nincsmega71/CL-415/README.md

# CL-415 RC vízibombázó

Kétmotoros, kefe nélküli hajtású Canadair CL-415 RC modell XPS habból, behúzható futóművel és az igazi géphez hasonló jelzőfényekkel.

Jelzőfények felülnézetben

## Főbb adatok

| | |
|---|---|
| Fesztáv | 1800 mm |
| Szárnyfelület | kb. 40 dm² |
| Súlycél | víz nélkül kb. 2,2–2,4 kg; 500 ml vízzel kb. 2,9 kg |
| Anyag | 5 mm XPS padlóalátét, 3 mm rétegelt lemez, coroplast / üvegszövet a hajótest alján |
| Hajtás | 2× 2830 1000–1100 kV, 2× 40 A ESC, 2× 8×6 négytollú (CW + CCW), 3S LiPo |
| Rádió | Turnigy TGY-i10 adó, FlySky FS-iA10B vevő (10 csatorna), i-BUS telemetria (feszültség, hőmérséklet, fordulatszám) |
| Futómű | behúzható: a Dumas-féle CL-215 futómű átméretezve (lengőkar + reteszelő merevítő, nyomtáv 328 mm), hátra behúzható ikerkerekes orrfutó; 5 szervó, saját XIAO vezérlővel |
| Fények és víz | helyzetfények, piros villogó, strobe, leszállófény; 500 ml-es kétrekeszes víztartály merítőlapokkal és két ürítőajtóval; Seeed XIAO RP2040 vezérlő i-BUS-on |

## Dokumentáció

| Fájl | Tartalom |
|---|---|
| [docs/SZERELESI_UTMUTATO.md](docs/SZERELESI_UTMUTATO.md) | Szerelési útmutató: fénypanel, firmware, fények, futómű, hajtás, RC bekötés, vízzárás, festés, végellenőrzés |
| [docs/FEDELZETI_VEZERLO.md](docs/FEDELZETI_VEZERLO.md) | Fedélzeti vezérlő v2 (XIAO, i-BUS): működés, kapcsolási rajz, lábkiosztás, teszt, beállítás |
| [docs/ADO_TURNIGY_I10.md](docs/ADO_TURNIGY_I10.md) | Turnigy i10 adó és FS-iA10B vevő: kezelőszervek, funkciókiosztás, failsafe, telemetria |
| [docs/I10_FIRMWARE_ELEMZES.md](docs/I10_FIRMWARE_ELEMZES.md) | Az i10 gyári firmware-ének vizsgálata: mi módosítható, kockázatok, következő lépés |
| [docs/FUTOMU_ES_TARTALY.md](docs/FUTOMU_ES_TARTALY.md) | Futómű és víztartály méretezett terve, SolidWorks-hez |
| [cad/](cad/) | DXF és STEP alkatrészek, összeállítások, SolidWorks paraméterlista, generálóprogramok |
| [docs/VIZTARTALY.md](docs/VIZTARTALY.md) | Víztartály: mennyi vizet bír a gép, tartály, ürítés, merítés |
| [docs/BOM.md](docs/BOM.md) | Alkatrészlista: fényvezérlő és teljes gép |
| [docs/TERVEK_ES_FORRASOK.md](docs/TERVEK_ES_FORRASOK.md) | A Paper-Replika terv letöltései és további források |
| [docs/elektronika.html](docs/elektronika.html) | Kapcsolási rajz és BOM egy oldalon (böngészőben megnyitható) |
| [docs/CL-415_Canadair_festes_matrica.pdf](docs/CL-415_Canadair_festes_matrica.pdf) | Canadair-stílusú festési séma és matricaív (A3) |
| [docs/img/](docs/img/) | Ábrák SVG-ben |
| [firmware/cl415_vezerlo/](firmware/cl415_vezerlo/cl415_vezerlo.ino) | Fedélzeti vezérlő firmware v2 (FS-iA10B, i-BUS) |
| [firmware/cl415_futomu/](firmware/cl415_futomu/cl415_futomu.ino) | Futómű-vezérlő (második XIAO): a főfutó szervóinak összehangolt mozgatása |
| [firmware/cl415_lights/](firmware/cl415_lights/cl415_lights.ino) | Régi fényvezérlő (v1, TGY-iA6B vevőhöz, CH5 PWM) |

## Ábrák

| | |
|---|---|
| Kapcsolási rajz v2 | Szárnykábelezés |
| Csatornakiosztás | Főfutó elölnézet |
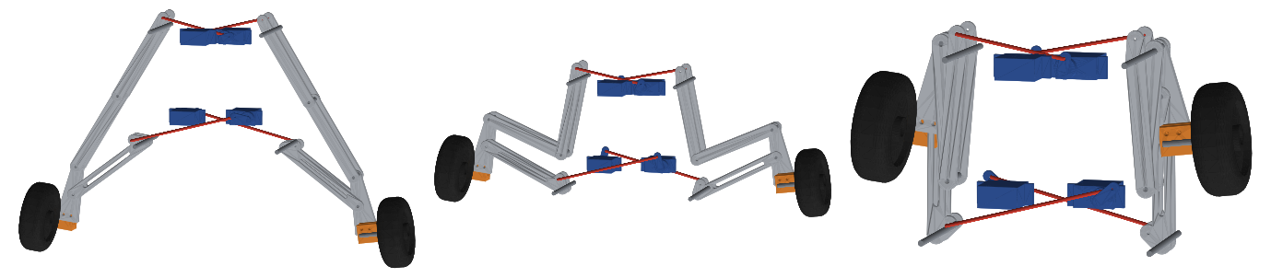
[picture p1: docs/img/step_elonezet.png]
3D modell
| A futómű mozgása |  |

## A sárkányszerkezet terve

A modell a [Paper-Replika CL-415](https://paper-replika.com/index.php/rc-foam-project/bombardier-cl-415-rc-plane-part-1?showall=1) ingyenes terve alapján épül (Julius Perdana). A tervek a szerző oldaláról tölthetők le; ebben a repóban csak a hivatkozások szerepelnek.
