nincsmega71/CL-415/docs/TERVEK_ES_FORRASOK.md

# Tervek és források

## A választott terv: Paper-Replika CL-415 (180 cm)

Julius Perdana ingyenes, habból épülő terve. Vízről és földről is üzemeltethető, a szárny három részre szedhető, és levehető a törzsről.

Eredeti adatok: 1800 mm fesztáv, 22 cm húr, 40 dm² szárnyfelület, kb. 2200 g repülősúly, 5 mm Depron/polifoam + 3 mm rétegelt lemez, 2× 2830 1000 kV motor, 2× 40 A ESC, 3S LiPo, 7 db 9 g-os szervó, 2× 8×6 négytollú légcsavar.

Ebben a projektben 5 mm-es XPS padlóalátéttel épül, 100%-os méretben, így a terv hornyai változtatás nélkül passzolnak.

| Rész | Tartalom | Link |
|---|---|---|
| 1. rész | törzs, függőleges vezérsík, futók | [cikk](https://paper-replika.com/index.php/rc-foam-project/bombardier-cl-415-rc-plane-part-1?showall=1) |
| 2. rész | vízszintes vezérsík, szervók, tolórudak | [cikk](https://paper-replika.com/index.php/rc-foam-project/bombardier-cl-415-rc-plane-part-2) |
| 3. rész | szárny | [PDF](https://paper-replika.com/dfiles/rcplans/PR_CL415_Part3.pdf) · [cikk](https://paper-replika.com/index.php/rc-foam-project/bombardier-cl-415-rc-plane-part-3) |
| 4. rész | úszók, befejezés | [PDF](https://paper-replika.com/dfiles/rcplans/PR_CL415_Part4.pdf) · [cikk](https://paper-replika.com/index.php/rc-foam-project/bombardier-cl-415-rc-plane-part-4) |

Nyomtatáskor „Tényleges méret” (100%) legyen beállítva, és az első lapon vonalzóval ellenőrizd a méretet.

A szerző tapasztalatai: az orrfutó kiugrott a helyéből (ezért itt csavarozott rétegelt lemez talpat kap), a csűrőfelületet meg kellett növelni, fordulóban sok oldalkormány kell.

## További tervek és modellek (referenciának)

| Forrás | Leírás |
|---|---|
| [Outerzone oz9788 – Mike Roach](https://outerzone.co.uk/plan_details.asp?ID=9788) | Bombardier CL-415, 1/24, 52" (≈1320 mm), Depron, ingyenes |
| [Outerzone oz16517 – Bernard Dumas](https://outerzone.co.uk/plan_details.asp?ID=16517) | Canadair CL-215, 2220 mm, vektoros PDF |
| [Outerzone oz6182 – Steve Gray](https://outerzone.co.uk/plan_details.asp?ID=6182) | Canadair CL-215, 76", sport-scale |
| [Aeronaut CL-415 építési útmutató](https://aero-naut.de/downloads/en/anleitungen/1343-00-Canadair_instructions_en.pdf) | 1505 mm-es fa készlet útmutatója, hajótest- és gondola-referencia |
| [Cults3D – Katraska CL-415](https://cults3d.com/en/3d-model/game/canadair-cl-415-katraska) | 1562 mm, LW-PLA, fizetős |
| [DARcorporation CL-415 CAD](https://shop.darcorp.com/index.php?route=product%2Fproduct&product_id=281) | külső forma, STEP / Parasolid, fizetős |
