nincsmega71/CL-415/docs/CL-415_Canadair_festes_matrica.pdf

# CL-415 – Canadair-stílusú festési séma

A klasszikus sárga–piros Canadair tűzoltógépek ihlette színezés a 180 cm-es Paper-Replika modellhez. Az ábrák nem méretarányosak.

## Oldalnézet (bal oldal)

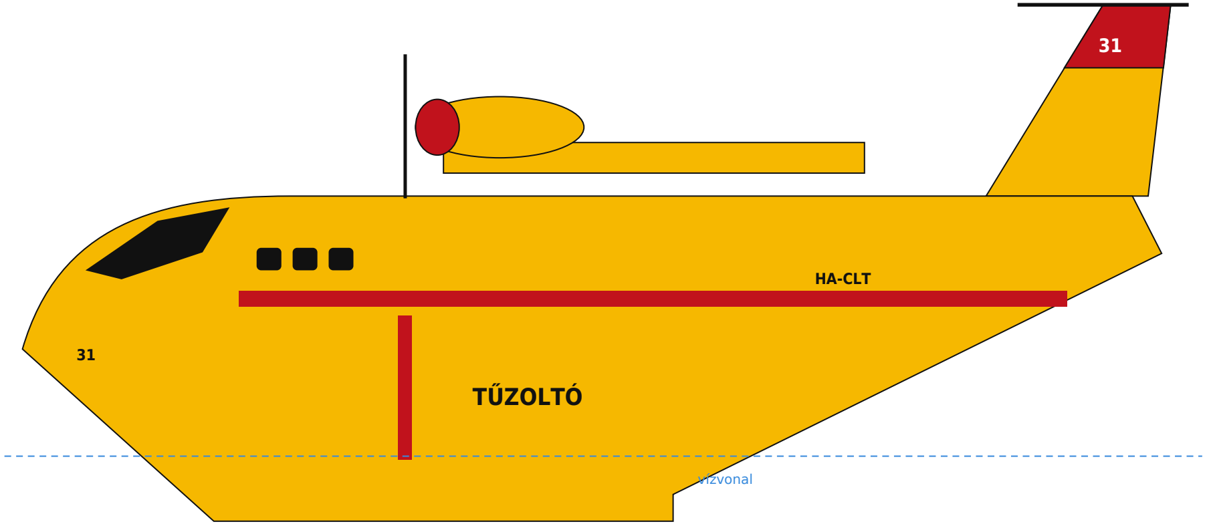
[picture p2: figure]
TŰZOLTÓ; HA-CLT; vízvonal

## Felülnézet

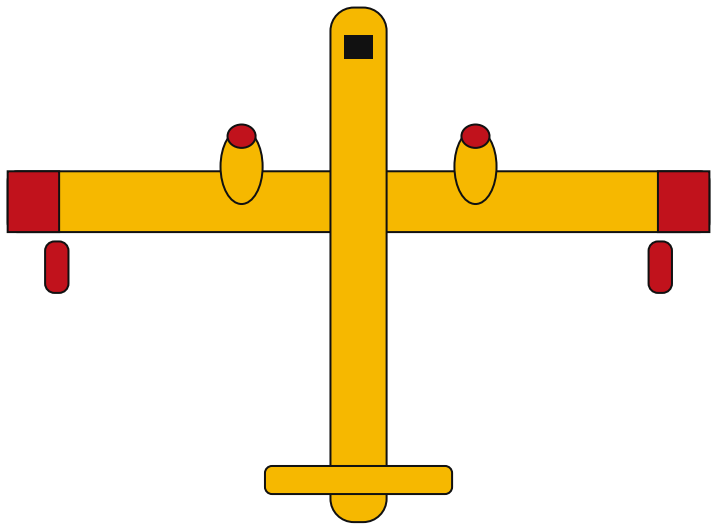
[picture p3: figure]

Alul: „HA-CLT” a bal szárny alsó felén, a szárnyvégtől befelé.

## Színek (vízbázisú akril; a RAL csak tájékoztató)

Sárga | RAL 1021 körül | törzs, szárny, vezérsíkok, gondolák – alapszín
Piros | RAL 3020 körül | függőleges vezérsík felső harmada, szárnyvégek (kb. 10 cm), úszók, gondolaorr, díszcsík, légcsavar-veszély csík
Fekete | RAL 9005 | tükröződésgátló mező a szélvédő előtt, ablakok (matrica), feliratok (matrica)
Fehér | – | számok a piros vezérsíkon (matrica)

## Festési sorrend

1. Vízzárás (coroplast / üvegszövet + epoxi) és csiszolás után vékony vízbázisú alapozó.
2. Sárga alapszín az egész gépre, 2–3 vékony rétegben ecsettel vagy hengerrel. Spray és oldószeres festék tilos (oldja az XPS-t).
3. Maszkolás papírszalaggal, majd a piros felületek. Utána a fekete tükröződésgátló mező.
4. Matricák felrakása (2. oldal), majd vízbázisú matt vagy selyemfényű lakk az egészre – ez védi a matricákat a víztől is.

Fiktív lajstrom és szám (HA-CLT, 31). Saját ötlet alapján, a valódi Canadair tűzoltógépek jellegzetes színezésére emlékeztetve.

## CL-415 – Canadair-stílusú matricák · fehér öntapadós vinyl · A3, 100%-os nyomtatás

Tintasugaras nyomtatóhoz való fehér vinyl matricapapírra nyomtasd, majd fújás helyett vízbázisú lakkal vagy átlátszó laminálófóliával védd. A szürke feliratokat ne vágd ki.

vezérsík-szám ×2 (piros alap)

31

vezérsík-szám ×2 (piros alap)

# 31 HA-CLT

lajstrom, bal szárny alul

# HA-CLT

lajstrom, törzs hátul ×2

# HA-CLT

lajstrom, törzs hátul ×2 | TŰZOLTÓ

törzs oldala ×2

# TŰZOLTÓ

törzs oldala ×2

31

orrszám ×2

31

orrszám ×2

CL-415

típusjel ×2

CL-415

típusjel ×2

# LÉGCSAVAR – VESZÉLY

légcsavar-veszély csík ×2

# LÉGCSAVAR – VESZÉLY

légcsavar-veszély csík ×2

# NE LÉPJ

szárnytő, vezérsík ×6

# NE LÉPJ

szárnytő, vezérsík ×6

# NE LÉPJ

szárnytő, vezérsík ×6

# NE LÉPJ

szárnytő, vezérsík ×6

# NE LÉPJ

szárnytő, vezérsík ×6

# NE LÉPJ

szárnytő, vezérsík ×6

piros díszcsík ×4 (törzs oldala, kettő oldalanként, toldva)

Méretellenőrzés: ennek a vonalnak pontosan 100 mm-nek kell lennie.
