nincsmega71/CL-415/cad/dxf/fo2_lengokar.dxf

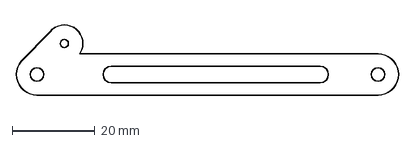
[picture p4: CAD file, 2026-11-07]
cad/dxf/fo2_lengokar.dxf
92.6 x 17.0 mm
