nincsmega71/CL-415/cad/step/alkatreszek/tartaly_test.step

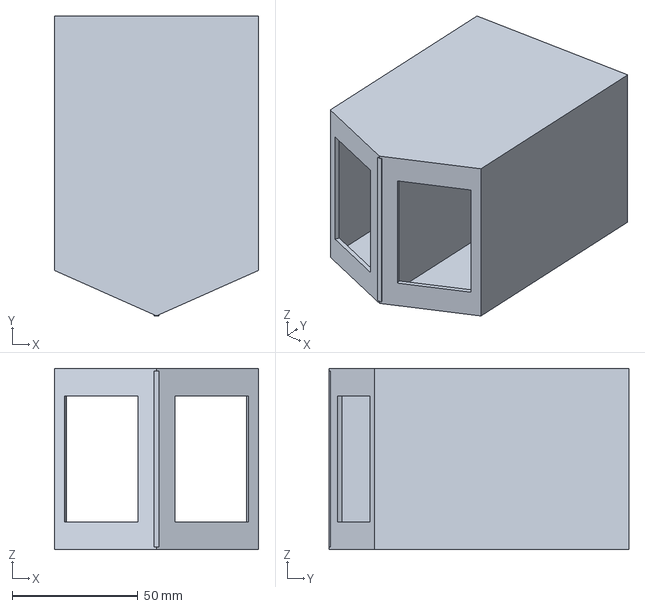
[picture p5: CAD file, 2026-11-07]
cad/step/alkatreszek/tartaly_test.step
81.0 x 119.0 x 72.0 mm
