nincsmega71/CL-415/cad/dxf/fo2_akna_belso_fal.dxf

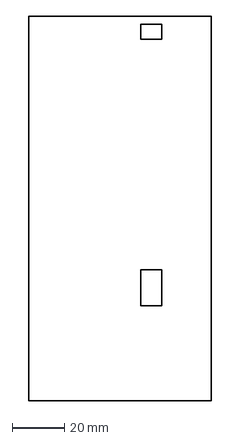
[picture p7: CAD file, 2026-11-07]
cad/dxf/fo2_akna_belso_fal.dxf
70.0 x 147.7 mm
