nincsmega71/CL-415/cad/step/alkatreszek/fo2_merevito_felso.step

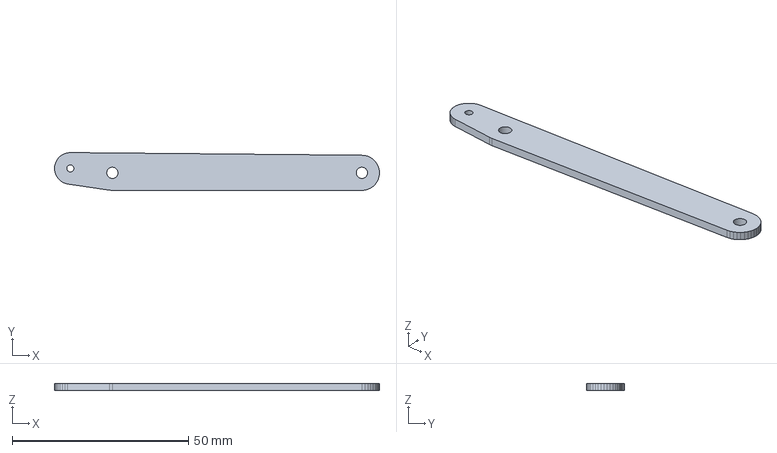
[picture p8: CAD file, 2026-11-07]
cad/step/alkatreszek/fo2_merevito_felso.step
92.3 x 10.8 x 2.00 mm
