nincsmega71/CL-415/cad/dxf/orrfuto_lab.dxf

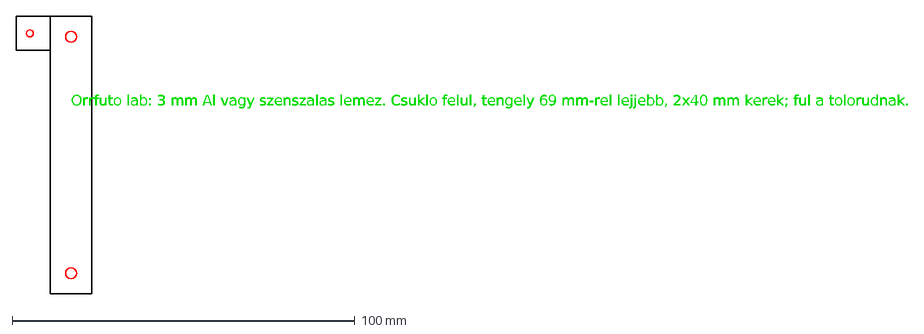
[picture p10: CAD file, 2026-11-07]
cad/dxf/orrfuto_lab.dxf
Orrfuto lab: 3 mm Al vagy szenszalas lemez. Csuklo felul, tengely 69 mm-rel lejjebb, 2x40 mm kerek; ful a tolorudnak.
