nincsmega71/CL-415/cad/step/alkatreszek/csapagy_MR63_3x6x2_5.step

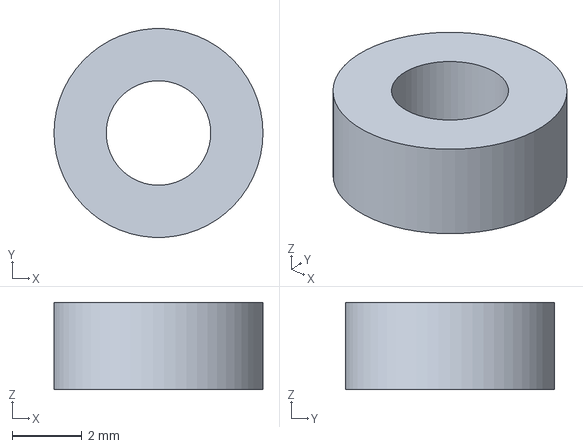
[picture p11: CAD file, 2026-11-07]
cad/step/alkatreszek/csapagy_MR63_3x6x2_5.step
6.00 x 5.99 x 2.50 mm
