nincsmega71/CL-415/cad/step/fofuto_felut.step

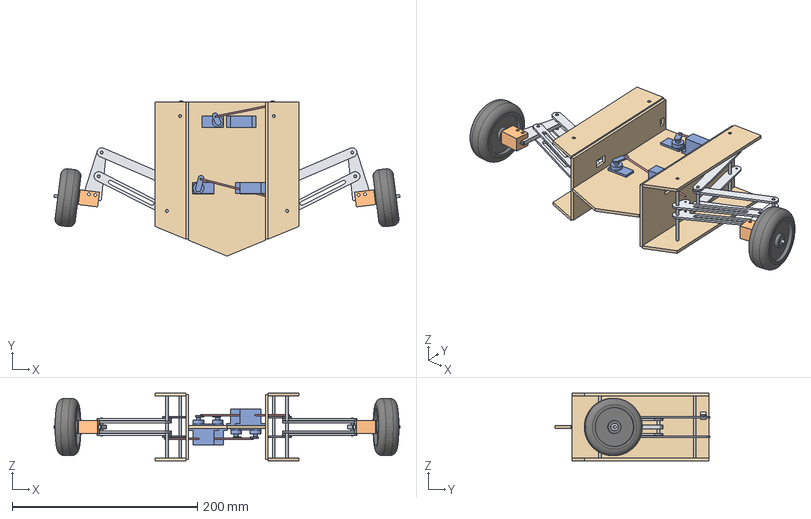
[picture p12: CAD file, 2026-11-07]
cad/step/fofuto_felut.step
373.3 x 167.4 x 73.0 mm
kozepso_former
belso_fal_J
akna_fal_Je
akna_fal_Jh
lengokar_Je
lengokar_Jh
merev_also_Je
merev_also_Jh
merev_felso_Je
merev_felso_Jh
lab_J
kerekbak_J
fokerek_J
csapagy_J1
csapagy_J2
tengely_J
csap_OT_J
csap_OB_J
csap_P1_J
csap_P2_J
csap_K_J
szervo_also_J
szervokar_also_J
szervo_felso_J
szervokar_felso_J
rud_also_J
rud_felso_J
belso_fal_B
akna_fal_Be
akna_fal_Bh
lengokar_Be
lengokar_Bh
merev_also_Be
merev_also_Bh
merev_felso_Be
merev_felso_Bh
lab_B
kerekbak_B
fokerek_B
csapagy_B1
csapagy_B2
tengely_B
csap_OT_B
csap_OB_B
csap_P1_B
csap_P2_B
csap_K_B
szervo_also_B
szervokar_also_B
szervo_felso_B
szervokar_felso_B
rud_also_B
rud_felso_B
