nincsmega71/CL-415/cad/dxf/fo2_merevito_also.dxf

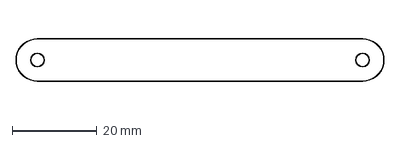
[picture p13: CAD file, 2026-11-07]
cad/dxf/fo2_merevito_also.dxf
86.8 x 10.0 mm
