nincsmega71/CL-415/cad/step/alkatreszek/csapagy_693_3x8x4.step

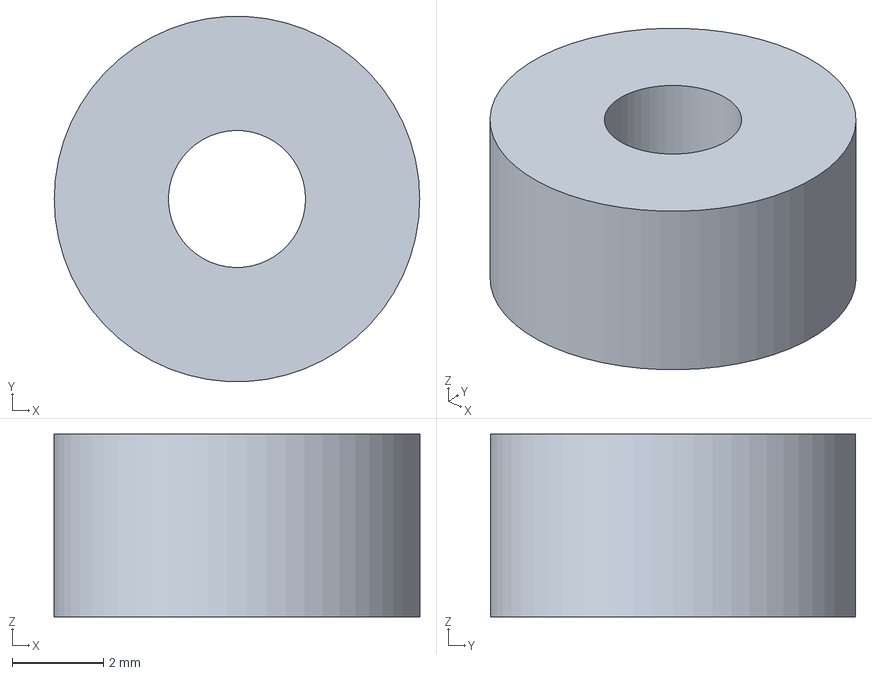
[picture p14: CAD file, 2026-11-07]
cad/step/alkatreszek/csapagy_693_3x8x4.step
8.00 x 7.99 x 4.00 mm
