nincsmega71/CL-415/cad/step/orrfuto.step

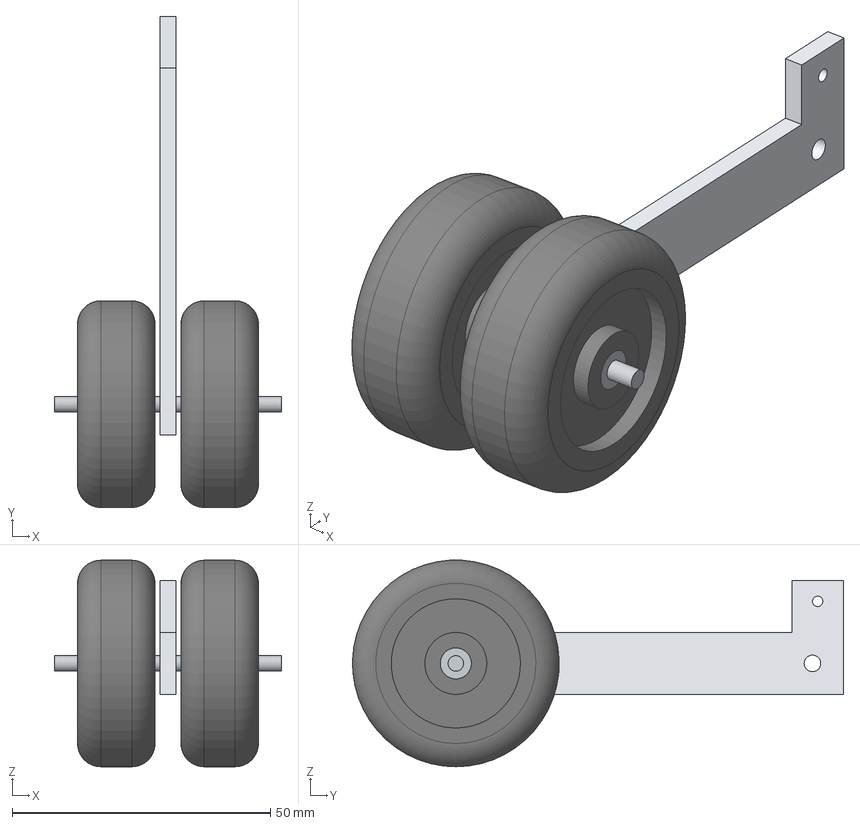
[picture p15: CAD file, 2026-11-07]
cad/step/orrfuto.step
44.0 x 95.0 x 40.0 mm
orrfuto_lab
tengely
orrkerek_J
tavtarto_J
csapagy_J1
csapagy_J2
orrkerek_B
tavtarto_B
csapagy_B1
csapagy_B2
