nincsmega71/CL-415/cad/dxf/tartaly_fenek.dxf

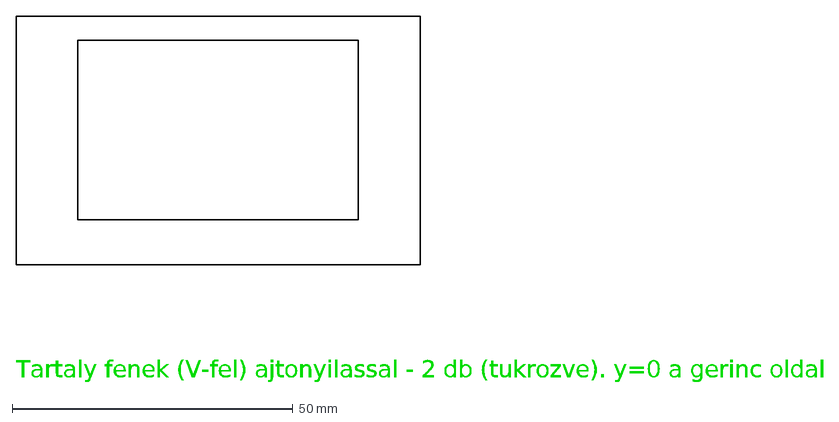
[picture p16: CAD file, 2026-11-07]
cad/dxf/tartaly_fenek.dxf
Tartaly fenek (V-fel) ajtonyilassal - 2 db (tukrozve). y=0 a gerinc oldal
