nincsmega71/CL-415/cad/step/alkatreszek/fo2_kozepso_former.step

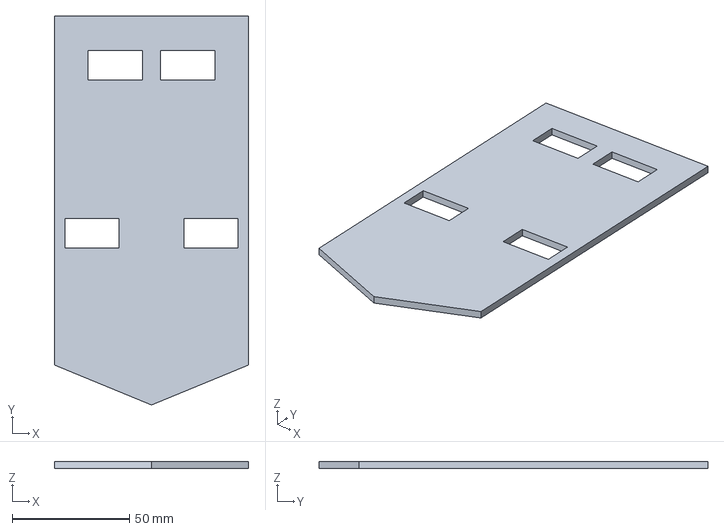
[picture p17: CAD file, 2026-11-07]
cad/step/alkatreszek/fo2_kozepso_former.step
83.0 x 166.0 x 3.00 mm
