nincsmega71/CL-415/cad/step/tartaly.step

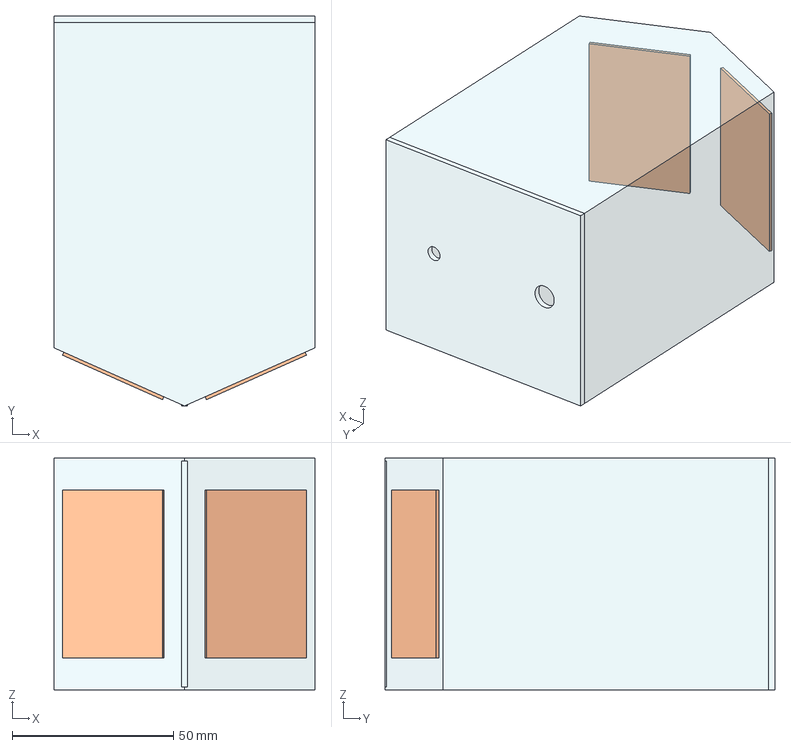
[picture p18: CAD file, 2026-11-07]
cad/step/tartaly.step
81.0 x 121.0 x 72.0 mm
tartaly_test
tartaly_teto
urito_ajto_J
urito_ajto_B
