nincsmega71/CL-415/cad/dxf/fo2_merevito_felso.dxf

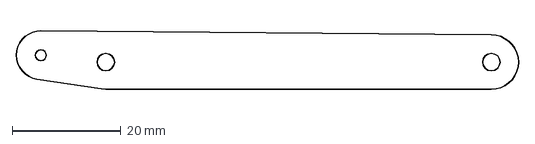
[picture p19: CAD file, 2026-11-07]
cad/dxf/fo2_merevito_felso.dxf
92.3 x 10.8 mm
