nincsmega71/CL-415/cad/step/alkatreszek/merito_lap.step

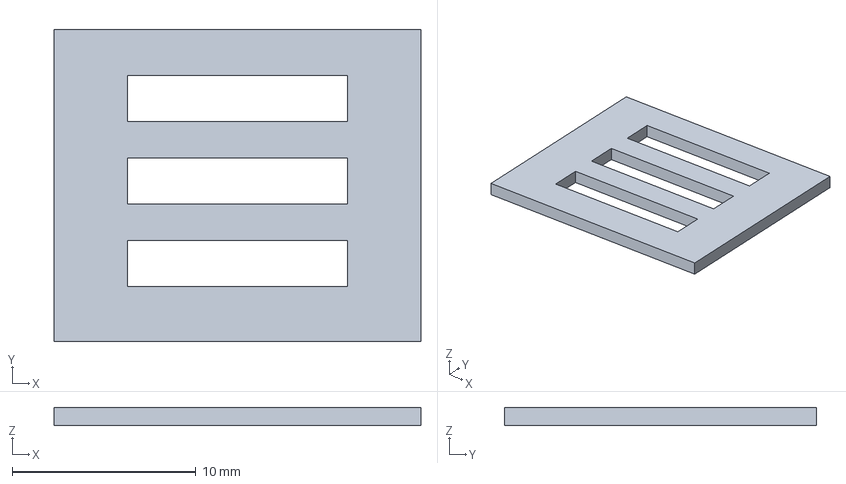
[picture p20: CAD file, 2026-11-07]
cad/step/alkatreszek/merito_lap.step
20.0 x 17.0 x 1.00 mm
