nincsmega71/CL-415/cad/dxf/merito_lap.dxf

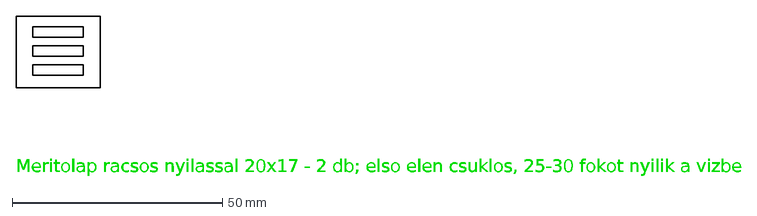
[picture p21: CAD file, 2026-11-07]
cad/dxf/merito_lap.dxf
Meritolap racsos nyilassal 20x17 - 2 db; elso elen csuklos, 25-30 fokot nyilik a vizbe
