nincsmega71/CL-415/cad/step/alkatreszek/szervo_MG90S_egyszerusitett.step

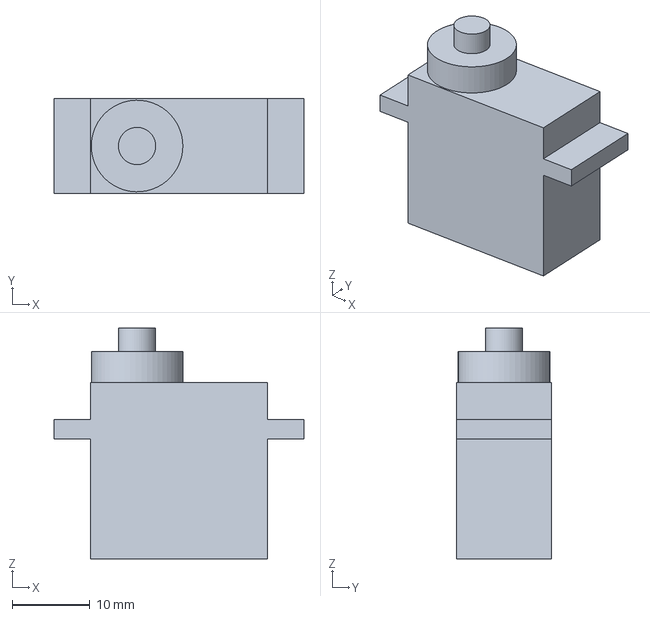
[picture p22: CAD file, 2026-11-07]
cad/step/alkatreszek/szervo_MG90S_egyszerusitett.step
32.2 x 12.2 x 29.7 mm
