nincsmega71/CL-415/cad/dxf/tartaly_oldal.dxf

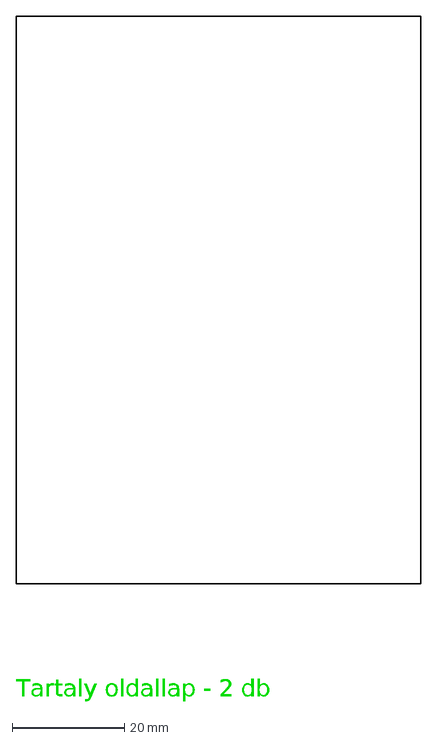
[picture p23: CAD file, 2026-11-07]
cad/dxf/tartaly_oldal.dxf
Tartaly oldallap - 2 db
