nincsmega71/CL-415/cad/step/alkatreszek/tengely_3x44.step

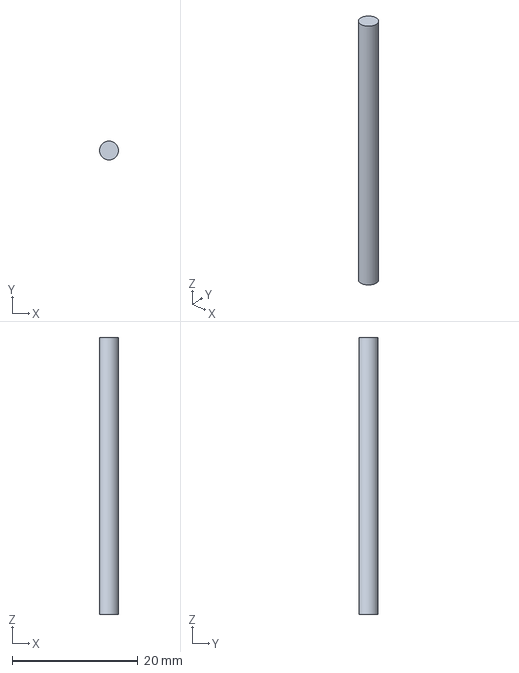
[picture p24: CAD file, 2026-11-07]
cad/step/alkatreszek/tengely_3x44.step
3.00 x 3.00 x 44.0 mm
