nincsmega71/CL-415/cad/dxf/orrfuto_aknaajto.dxf

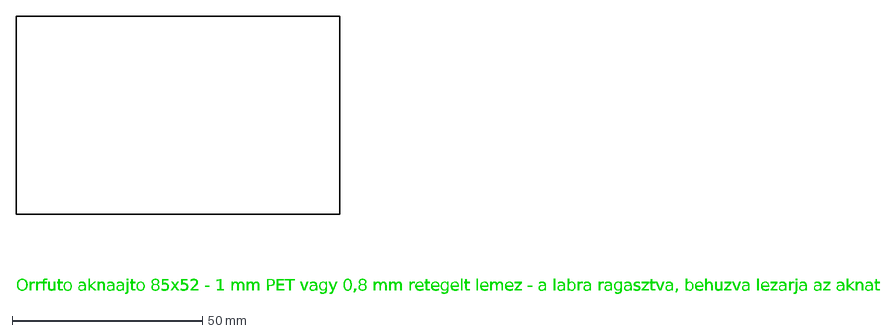
[picture p25: CAD file, 2026-11-07]
cad/dxf/orrfuto_aknaajto.dxf
Orrfuto aknaajto 85x52 - 1 mm PET vagy 0,8 mm retegelt lemez - a labra ragasztva, behuzva lezarja az aknat
