nincsmega71/CL-415/cad/step/alkatreszek/tavtarto_fokerek_5x3_2x14.step

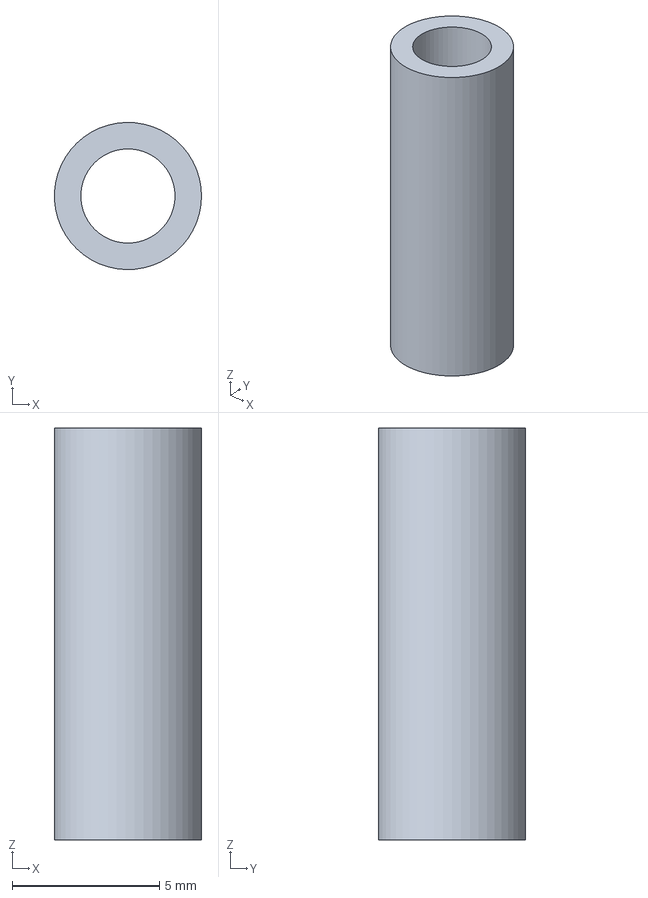
[picture p26: CAD file, 2026-11-07]
cad/step/alkatreszek/tavtarto_fokerek_5x3_2x14.step
5.00 x 5.00 x 14.0 mm
