nincsmega71/CL-415/cad/dxf/fo2_lab.dxf

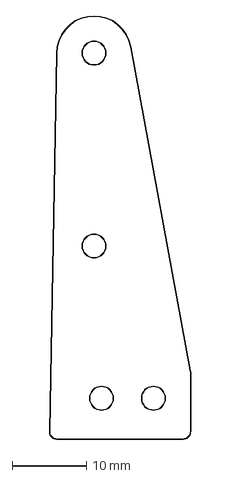
[picture p27: CAD file, 2026-11-07]
cad/dxf/fo2_lab.dxf
19.0 x 57.0 mm
