nincsmega71/CL-415/cad/step/alkatreszek/tengely_3x40.step

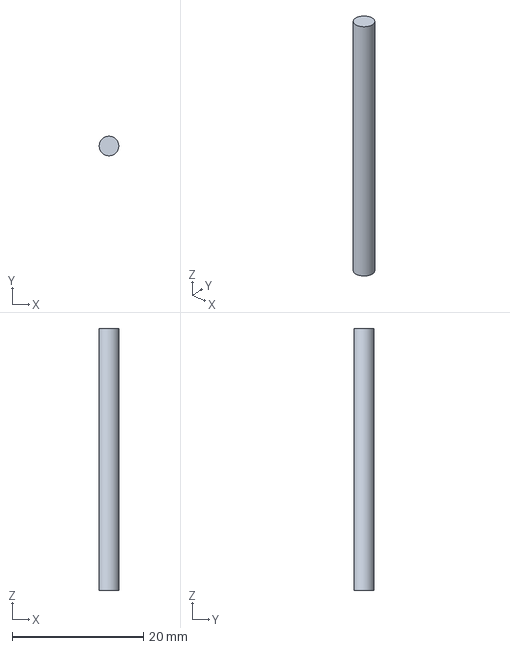
[picture p28: CAD file, 2026-11-07]
cad/step/alkatreszek/tengely_3x40.step
3.00 x 3.00 x 40.0 mm
