nincsmega71/CL-415/cad/dxf/tartaly_valaszfal.dxf

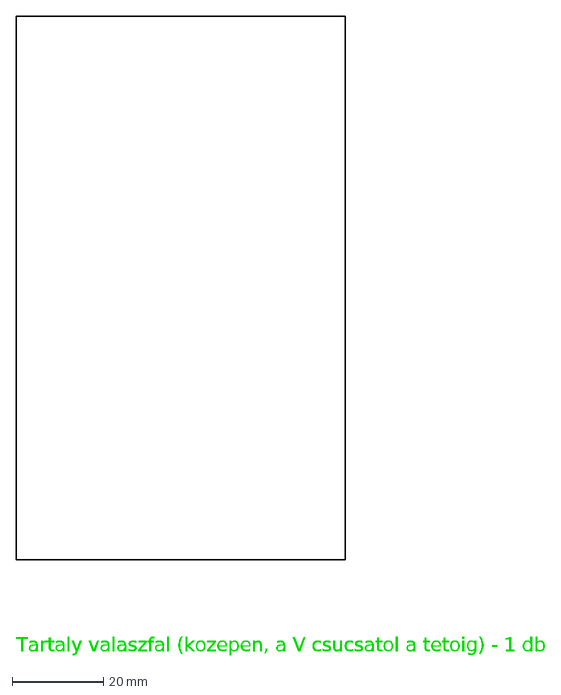
[picture p29: CAD file, 2026-11-07]
cad/dxf/tartaly_valaszfal.dxf
Tartaly valaszfal (kozepen, a V csucsatol a tetoig) - 1 db
