nincsmega71/CL-415/cad/step/alkatreszek/fo2_akna_elso_hatso_fal.step

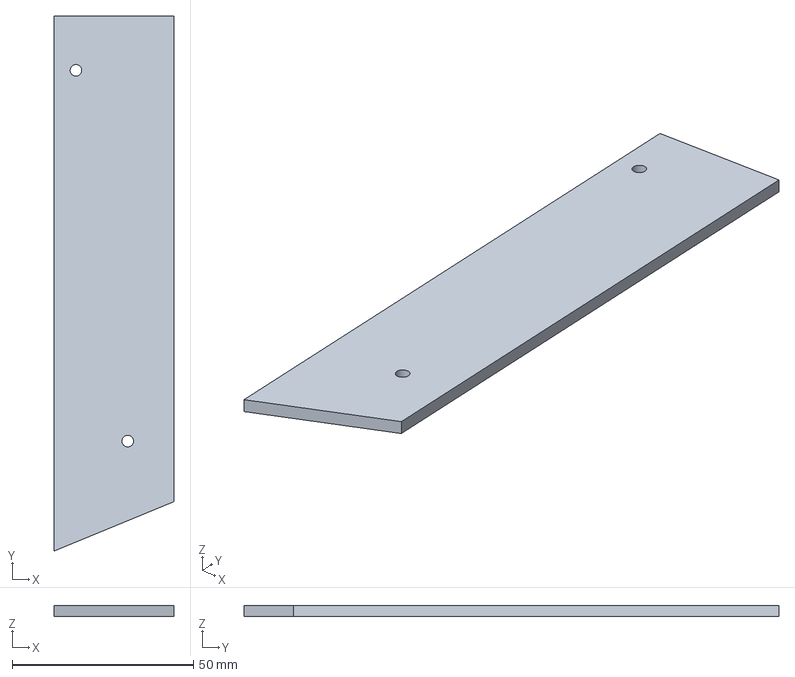
[picture p30: CAD file, 2026-11-07]
cad/step/alkatreszek/fo2_akna_elso_hatso_fal.step
33.0 x 147.7 x 3.00 mm
