nincsmega71/CL-415/cad/dxf/fo2_kozepso_former.dxf

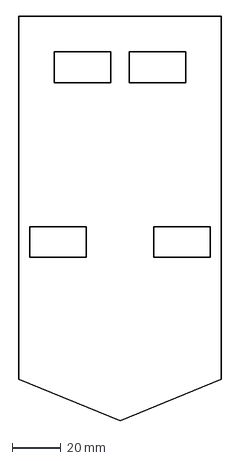
[picture p31: CAD file, 2026-11-07]
cad/dxf/fo2_kozepso_former.dxf
83.0 x 166.0 mm
