nincsmega71/CL-415/cad/step/alkatreszek/fo2_akna_belso_fal.step

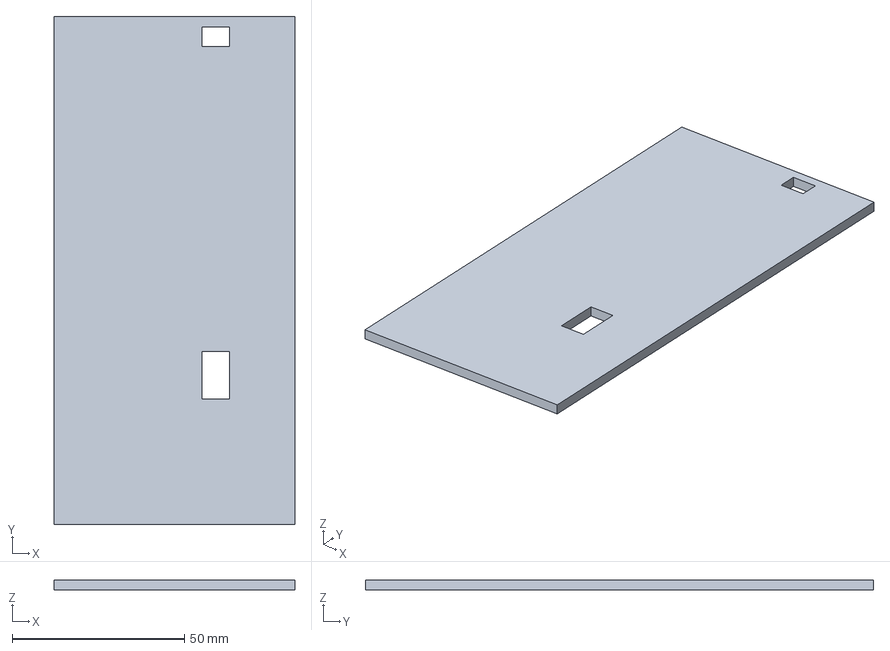
[picture p32: CAD file, 2026-11-07]
cad/step/alkatreszek/fo2_akna_belso_fal.step
70.0 x 147.7 x 3.00 mm
