nincsmega71/CL-415/cad/dxf/tartaly_eleje_hatulja.dxf

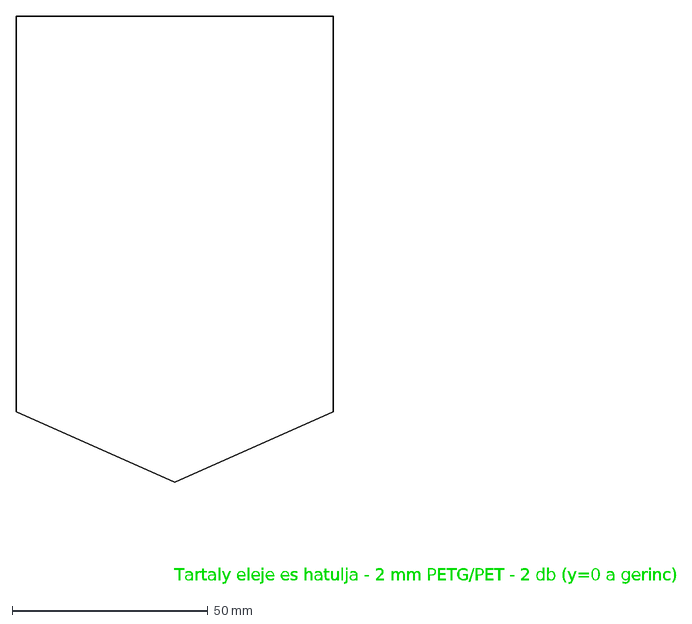
[picture p33: CAD file, 2026-11-07]
cad/dxf/tartaly_eleje_hatulja.dxf
Tartaly eleje es hatulja - 2 mm PETG/PET - 2 db (y=0 a gerinc)
