nincsmega71/CL-415/cad/step/alkatreszek/fo2_merevito_also.step

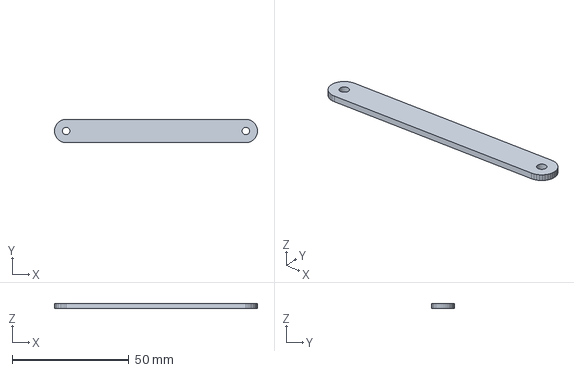
[picture p34: CAD file, 2026-11-07]
cad/step/alkatreszek/fo2_merevito_also.step
86.8 x 10.0 x 2.00 mm
