nincsmega71/CL-415/cad/dxf/fo2_akna_elso_hatso_fal.dxf

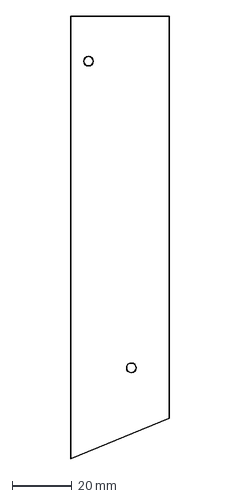
[picture p35: CAD file, 2026-11-07]
cad/dxf/fo2_akna_elso_hatso_fal.dxf
33.0 x 147.7 mm
