nincsmega71/CL-415/cad/step/alkatreszek/fo2_kerekbak.step

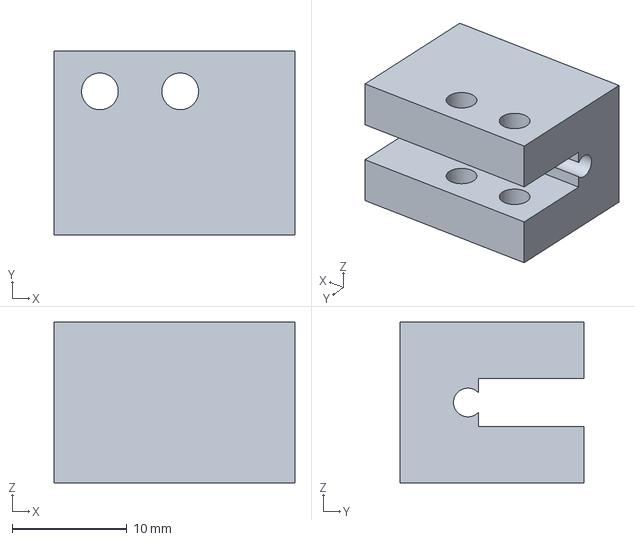
[picture p36: CAD file, 2026-11-07]
cad/step/alkatreszek/fo2_kerekbak.step
21.0 x 16.0 x 14.0 mm
