nincsmega71/CL-415/cad/dxf/tartaly_teto.dxf

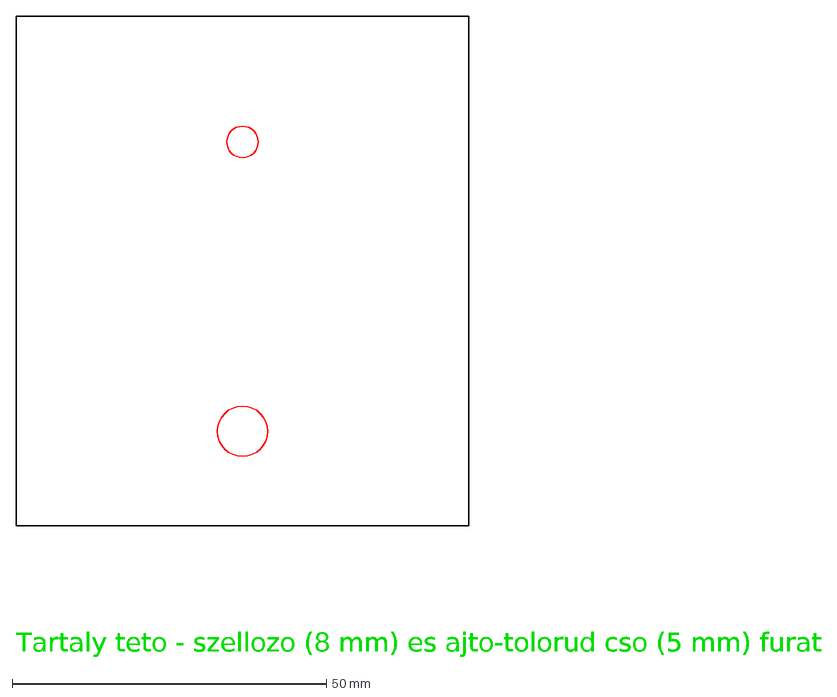
[picture p37: CAD file, 2026-11-07]
cad/dxf/tartaly_teto.dxf
Tartaly teto - szellozo (8 mm) es ajto-tolorud cso (5 mm) furat
