nincsmega71/CL-415/cad/step/alkatreszek/tavtarto_orrkerek_4x3_2x10.step

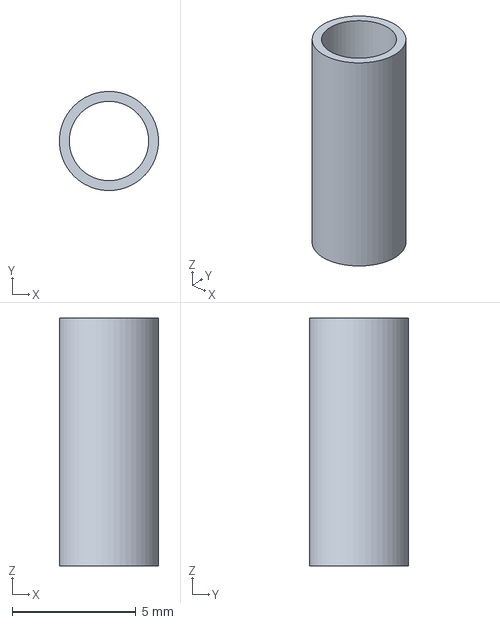
[picture p38: CAD file, 2026-11-07]
cad/step/alkatreszek/tavtarto_orrkerek_4x3_2x10.step
4.00 x 4.00 x 10.0 mm
