nincsmega71/CL-415/cad/dxf/urito_ajto.dxf

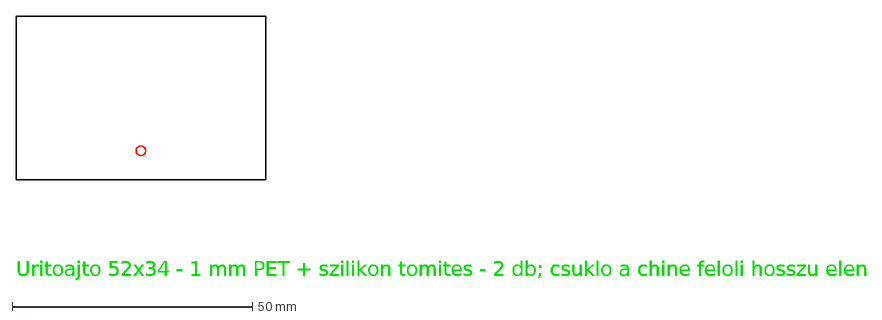
[picture p39: CAD file, 2026-11-07]
cad/dxf/urito_ajto.dxf
Uritoajto 52x34 - 1 mm PET + szilikon tomites - 2 db; csuklo a chine feloli hosszu elen
