nincsmega71/CL-415/cad/step/alkatreszek/orrfuto_lab.step

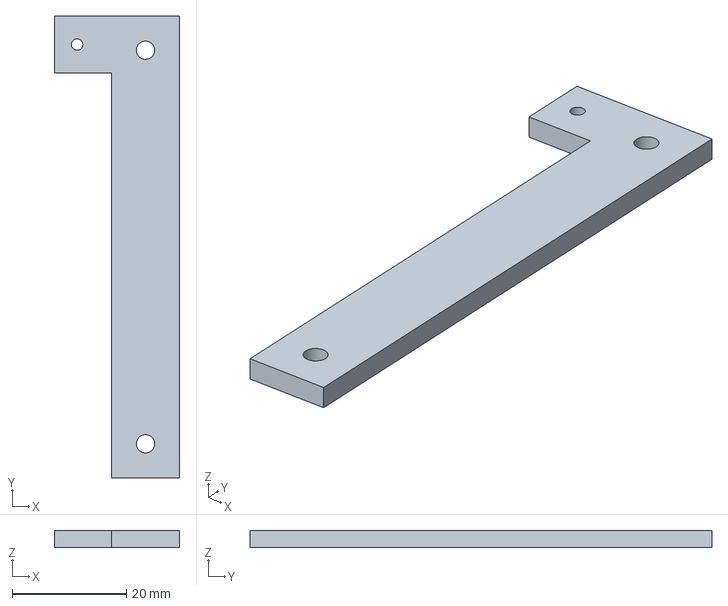
[picture p40: CAD file, 2026-11-07]
cad/step/alkatreszek/orrfuto_lab.step
22.0 x 81.0 x 3.00 mm
