nincsmega71/CL-415/cad/step/alkatreszek/urito_ajto.step

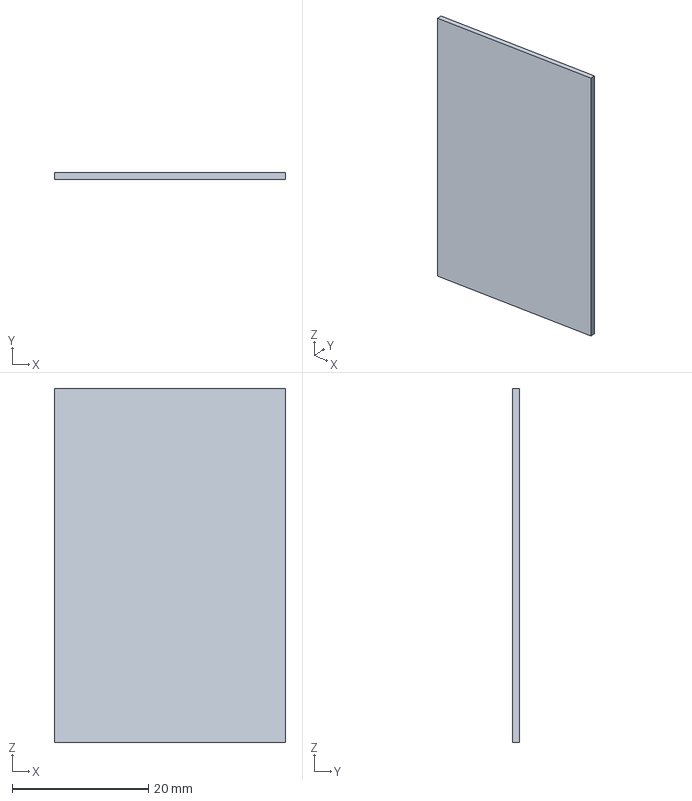
[picture p41: CAD file, 2026-11-07]
cad/step/alkatreszek/urito_ajto.step
34.0 x 1.00 x 52.0 mm
