nincsmega71/CL-415/cad/step/alkatreszek/fo2_lengokar.step

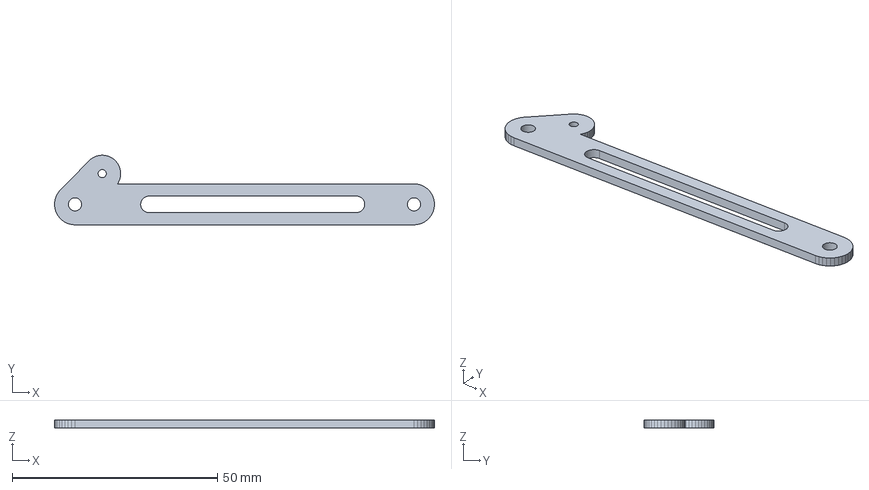
[picture p42: CAD file, 2026-11-07]
cad/step/alkatreszek/fo2_lengokar.step
92.6 x 17.0 x 2.00 mm
