nincsmega71/CL-415/cad/step/alkatreszek/fokerek_62x22_693.step

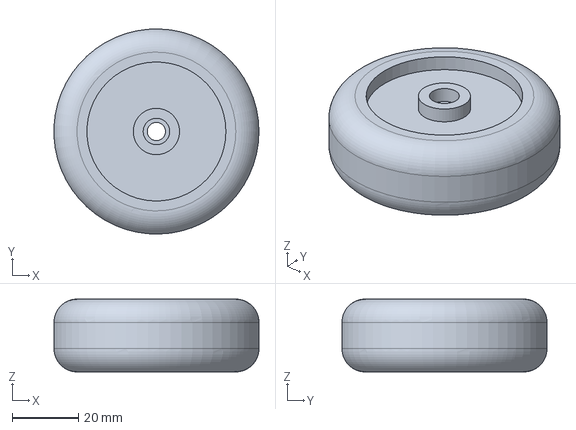
[picture p43: CAD file, 2026-11-07]
cad/step/alkatreszek/fokerek_62x22_693.step
62.0 x 62.0 x 22.0 mm
