nincsmega71/CL-415/cad/step/alkatreszek/fo2_lab.step

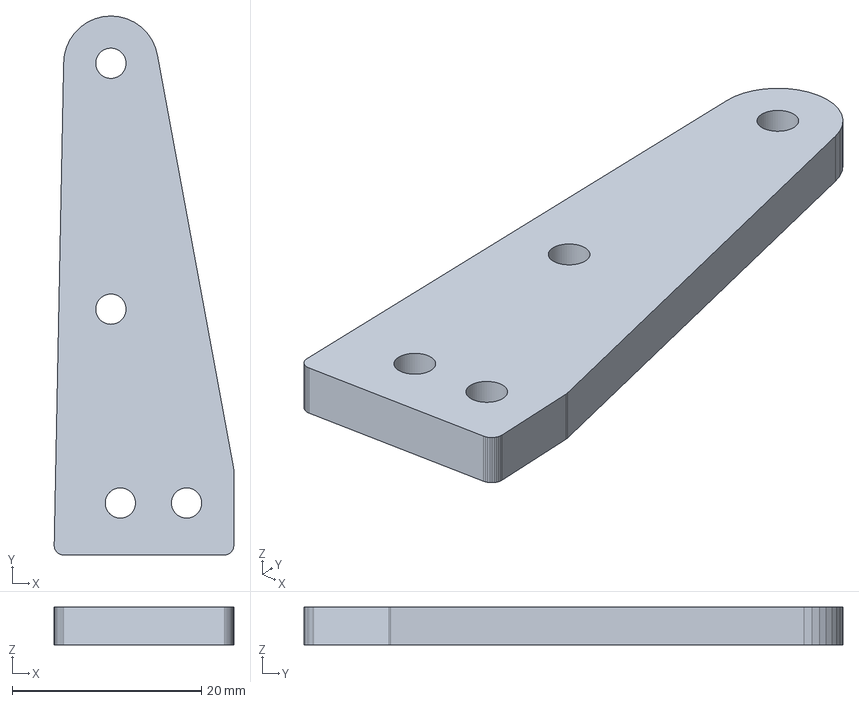
[picture p44: CAD file, 2026-11-07]
cad/step/alkatreszek/fo2_lab.step
19.0 x 57.0 x 4.00 mm
