nincsmega71/CL-415/cad/step/alkatreszek/tartaly_teto.step

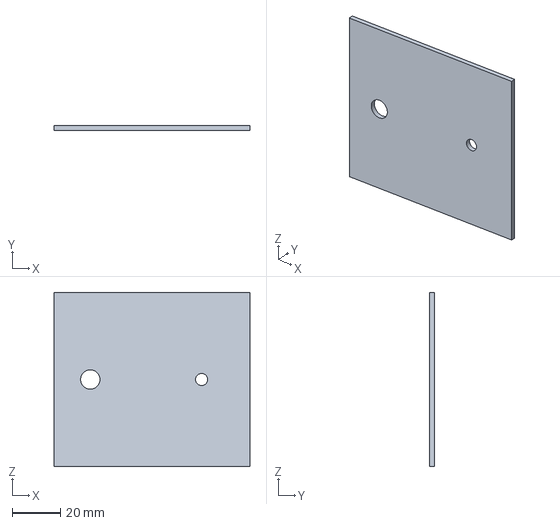
[picture p45: CAD file, 2026-11-07]
cad/step/alkatreszek/tartaly_teto.step
81.0 x 2.00 x 72.0 mm
