nincsmega71/CL-415/cad/step/alkatreszek/orrkerek_40x15_MR63.step

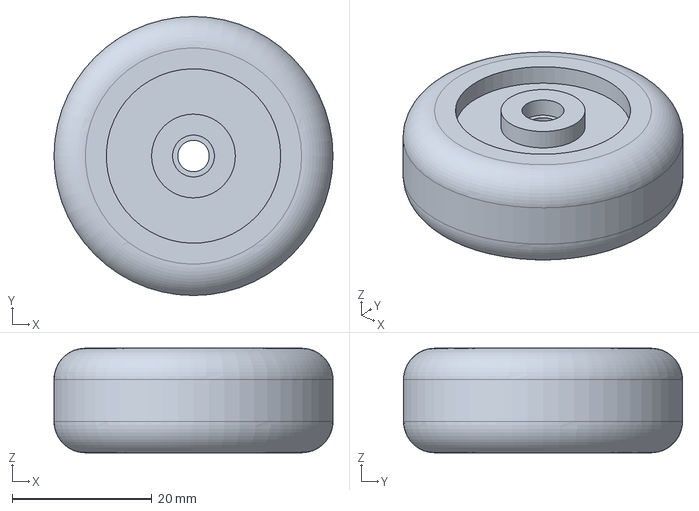
[picture p46: CAD file, 2026-11-07]
cad/step/alkatreszek/orrkerek_40x15_MR63.step
40.0 x 40.0 x 15.0 mm
