nincsmega71/CL-415/(list of files, cad)

Other CAD files:
cad/step/alkatreszek/fo2_kerekbak.stl
cad/step/alkatreszek/fokerek_62x22_693.stl
cad/step/alkatreszek/merito_lap.stl
cad/step/alkatreszek/orrkerek_40x15_MR63.stl
cad/step/alkatreszek/tartaly_test.stl
cad/step/alkatreszek/tartaly_teto.stl
