nincsmega71/CL-415/firmware/cl415_futomu/mozgas_tabla.h

// Automatikusan generált: cad/gen_futomu_v2.py – ne kézzel módosítsd.
// A főfutó szervóinak szöge (fok, a szervó középállásához képest) a behúzott (0) és
// a kiengedett (utolsó) állapot között, egyenlő lépésekben.
#pragma once
const int MOZGAS_PONTOK = 41;
const float BEHUZO_SZOG[MOZGAS_PONTOK] = {63.75f, 60.56f, 57.37f, 54.19f, 51.00f, 47.81f, 44.62f, 41.44f, 38.25f, 35.06f, 31.88f, 28.69f, 25.50f, 22.31f, 19.12f, 15.94f, 12.75f, 9.56f, 6.38f, 3.19f, 0.00f, -3.19f, -6.38f, -9.56f, -12.75f, -15.94f, -19.12f, -22.31f, -25.50f, -28.69f, -31.88f, -35.06f, -38.25f, -41.44f, -44.62f, -47.81f, -51.00f, -54.19f, -57.38f, -60.56f, -63.75f};
const float RETESZ_SZOG[MOZGAS_PONTOK] = {-30.00f, -28.86f, -27.43f, -26.44f, -25.67f, -25.03f, -24.47f, -23.97f, -23.50f, -23.06f, -22.64f, -22.22f, -21.81f, -21.40f, -21.00f, -20.59f, -20.17f, -19.74f, -19.30f, -18.85f, -18.38f, -17.89f, -17.38f, -16.84f, -16.27f, -15.66f, -15.01f, -14.32f, -13.56f, -12.74f, -11.84f, -10.83f, -9.70f, -8.42f, -6.93f, -5.18f, -3.03f, -0.31f, 3.41f, 9.28f, 30.00f};
