nincsmega71/CL-415/(commit log)

2026-11-04 CL-415 dokumentáció: szerelési útmutató, BOM, ábrák, fényvezérlő firmware
    Claude-Session: https://claude.ai/code/session_012BMU5s6R1JpHotCPctjDdq
2026-11-04 Fedélzeti vezérlő v2: i-BUS SERVO + SENS, víz funkció, telemetria; 500 ml; oldalsó karok
    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
2026-11-05 Futómű és víztartály méretezett terve: rajzok, DXF, SolidWorks paraméterek
    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
    [cl415_parameterek.txt, fofuto_former.dxf, fofuto_kar_also.dxf, fofuto_kar_felso.dxf, fofuto_konzol_ful.dxf, fofuto_lab_furatok.dxf, merito_lap.dxf, orrfuto_aknaajto.dxf]
2026-11-05 Paraméterlista: SolidWorks megjegyzés-szintaxis
    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
    [cl415_parameterek.txt, fofuto_former.dxf, fofuto_kar_also.dxf, fofuto_kar_felso.dxf, fofuto_konzol_ful.dxf, fofuto_lab_furatok.dxf, merito_lap.dxf, orrfuto_aknaajto.dxf]
2026-11-05 STEP 3D modellek: főfutó, orrfutó, tartály, kerekek; konzolfül a former lapjaira
    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
    [csapagy_693_3x8x4.step, csapagy_MR63_3x6x2_5.step, fofuto_behuzva.step, fofuto_former.dxf, fofuto_former.step, fofuto_kar_also.dxf, fofuto_kar_also.step, fofuto_kar_felso.dxf]
2026-11-07 Főfutó v2: a Dumas-féle CL-215 futómű átméretezve, szervókkal és futómű-vezérlővel
    - futomu_kinematika.py: a DWG-ből kiolvasott geometria 0,81x, a törzshöz igazítva
    - rajzok, DXF, STEP (kiengedve, félúton, behúzva), mozgástáblázat
    - firmware/cl415_futomu: második XIAO, a 4 főfutó- és az orrfutószervó összehangolt mozgatása
    - tartály a futóaknák közé (81 x 72 x 124 mm, 557 ml), orrfutó-láb 69 mm
    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
    [cl415_parameterek.txt, csapagy_693_3x8x4.step, csapagy_MR63_3x6x2_5.step, fo2_akna_belso_fal.dxf, fo2_akna_belso_fal.step, fo2_akna_elso_hatso_fal.dxf, fo2_akna_elso_hatso_fal.step, fo2_kerekbak.step]
